defermelowie/RV32I-course-project/docs/immediate_generator.md

# Immediate generator

The immediate generator is based on the figure below.

Immediate format

*Source: https://riscv.org/wp-content/uploads/2017/05/riscv-spec-v2.2.pdf Figure 2.4*
