defermelowie/RV32I-course-project/src/mem_modes.h

// -- Memory mode encoding ------------------------------------
parameter MEM_BYTE = 'b00;    // Store/read byte's (8-bit)
parameter MEM_HALF = 'b01;    // Store/read half words (16-bit)
parameter MEM_WORD = 'b10;    // Store/read words (32-bit)
