defermelowie/RV32I-course-project/src/ram_codes.h

// -- ram byte enable codes ---------------------------------
parameter ENABLE_BYTE = 4'b0001;        // enable byte
parameter ENABLE_HALFWORD = 4'b0011;    // enable half word
parameter ENABLE_WORD = 4'b1111;        // enable word
