defermelowie/RV32I-course-project/src/RISCV.h

// -- Data length ---------------------------------------------
parameter XLEN = 32;

// -- Memory mapped IO ----------------------------------------
parameter IO_INPUT_BUS_LEN = 14;
parameter IO_OUTPUT_BUS_LEN = 52;
parameter IO_BASE_ADDR = 712;
