defermelowie/RV32I-course-project/src/comparison_codes.h

// -- Branch comparison encoding ------------------------------
parameter EQ = 'b001;   // Equal
parameter NE = 'b010;   // Not equal
parameter LT = 'b011;   // Less than
parameter GE = 'b100;   // Greater than or equal to
parameter LTU = 'b101;  // Less than unsigned
parameter GEU = 'b110;  // Greater than or equal to unsigned
