defermelowie/RV32I-course-project/(commit log)

2020-12-19 Added extra tests & fixed errors
    [alu.v, alu_tb.v]
2020-12-30 Added invert zero input
    [alu.v, alu_tb.v]
2021-01-02 Removed alu invert zero output
    [control.v]
2021-01-03 Fixed error (reset puts pc at 1 instead of 0)
    [core.v]
2021-01-03 Added test assembly programs
2021-01-03 Added control hazard test assembly
2021-01-05 added schematic of data mem
2021-01-05 Changed test assembly
2021-01-05 Fixed Quartus elaboration errors/warnings
    [RISCV.h, alu.v, branch_comparison_unit.v, core.v]
2021-01-05 Add simple assembly to test write to mem
2021-01-05 Added basic io test assembly program
2021-01-06 Fixed: missed first instruction after reset
    [core_tb.v]
2021-01-06 Fixed problems with signed operations
    [alu.v, alu_tb.v]
2021-01-06 Fixed problems with signed comparisons
    [branch_comparison_unit.v]
2021-01-11 fixed io_output early in EX stage
    [data_memory.v]
2021-01-16 fixed merge errors from commit aea2e4a105aa03103ce359b511f02bcd06dc566d
    [core.v]
2021-01-16 Fixed remaining merge errors
    [core.v]
2021-01-16 Edited assembler to new io base adress
2021-01-19 Added small assembly program for memory testing
2021-01-19 fixed "byte enable is always 'b0000" mistake
    [core.v]
2021-01-20 nightrider assembly added
2021-01-23 fixed little mistakes in data memory
    [data_memory.v, instruction_memor_ip_substitute.v]
2021-01-25 added decimal counter to knightrider assembly code
2021-01-25 added reset for gpio registers
    [data_memory.v]
2021-01-25 fixed error with if else structure in data memory
    [data_memory.v]
2021-01-25 added sb en sh for io's and added reset
    [data_memory.v, instruction_memor_ip_substitute.v]
2021-01-25 sb and sh works, reset not yet
    [data_memory.v]
2021-01-26 Added reset to data mem inputs
    [core.v]
2021-01-26 Added reset in substitutes
    [data_memory_ip_substitute.v, instruction_memor_ip_substitute.v]
2021-01-26 added test assembly file
2021-01-26 Created core schematic
2021-01-26 fixed branch forwarding mistake
    [core.v]
